spstack/panel_lamp/README.md

# Instrument Panel Lamp

I got this old instrument panel out of a printing press that was (unfortunately) being scrapped.
Decided to make it into a cool looking lamp so it's not only a neat display, but also somewhat functional.

The finished instrument panel lamp
The finished instrument panel lamp

I'm honestly not sure what the panel controlled on the old printing press, but it's pretty cool looking and
has some super satisfying switches to press.

It uses all of the original knobs and buttons to control various aspects of the lamp.

The toggle switch in the center is the main on/off switch for the whole thing. It's wired through one
of the fuses on the front panel as well.

The left knob controls the brightness of the main lamp bulb. It's an autotransformer, so it can just
be directly hooked up to the bulb to control brightness.

The other switches/knobs are tied to an arduino that controls back-lighting LEDs

## Schematic

<a href="images/panel-sch1.jpg">Schematic page 1</a>
<a href="images/panel-sch2.jpg">Schematic page 2</a>
<a href="images/panel-sch3.jpg">Schematic page 3</a>

## PCB Layout

<a href="images/panel-pcb.jpg">PCB layout</a>
