spstack/panel_lamp/(list of files, cad)

Other CAD files:
board_design/components/4914/4914.STEP
board_design/components/IRM_03_5/IRM-03-5.STEP
board_design/components/OSTYK51102030/OSTYK51102030/OSTYK51102030.STEP
board_design/InstrumentPanelLamp/InstrumentPanelLampPcb.step
