spstack/panel_lamp/board_design/InstrumentPanelLamp/InstrumentPanelLamp.kicad_pcb

## KiCad design board_design/InstrumentPanelLamp/InstrumentPanelLamp.kicad_pcb (2026-01-28)

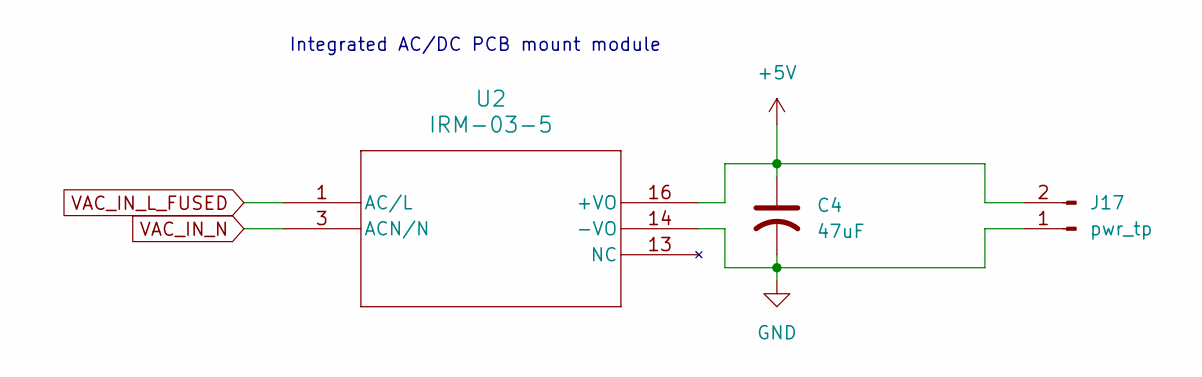
[picture p1: schematic power.kicad_sch]

Parts:
C4: 47uF; CP_Radial_D8.0mm_P3.50mm
J17: pwr_tp; PinHeader_1x02_P2.54mm_Vertical
U2: IRM-03-5; IRM-03_MWU

Connections:
+5V: C4.1, J17.2, U2.16 (+VO); also elsewhere on the board
GND: C4.2, J17.1, U2.14 (-VO); also elsewhere on the board
VAC_IN_L_FUSED: U2.1 (AC/L); also elsewhere on the board
VAC_IN_N: U2.3 (ACN/N); also elsewhere on the board

Notes on the sheet:
Integrated AC/DC PCB mount module

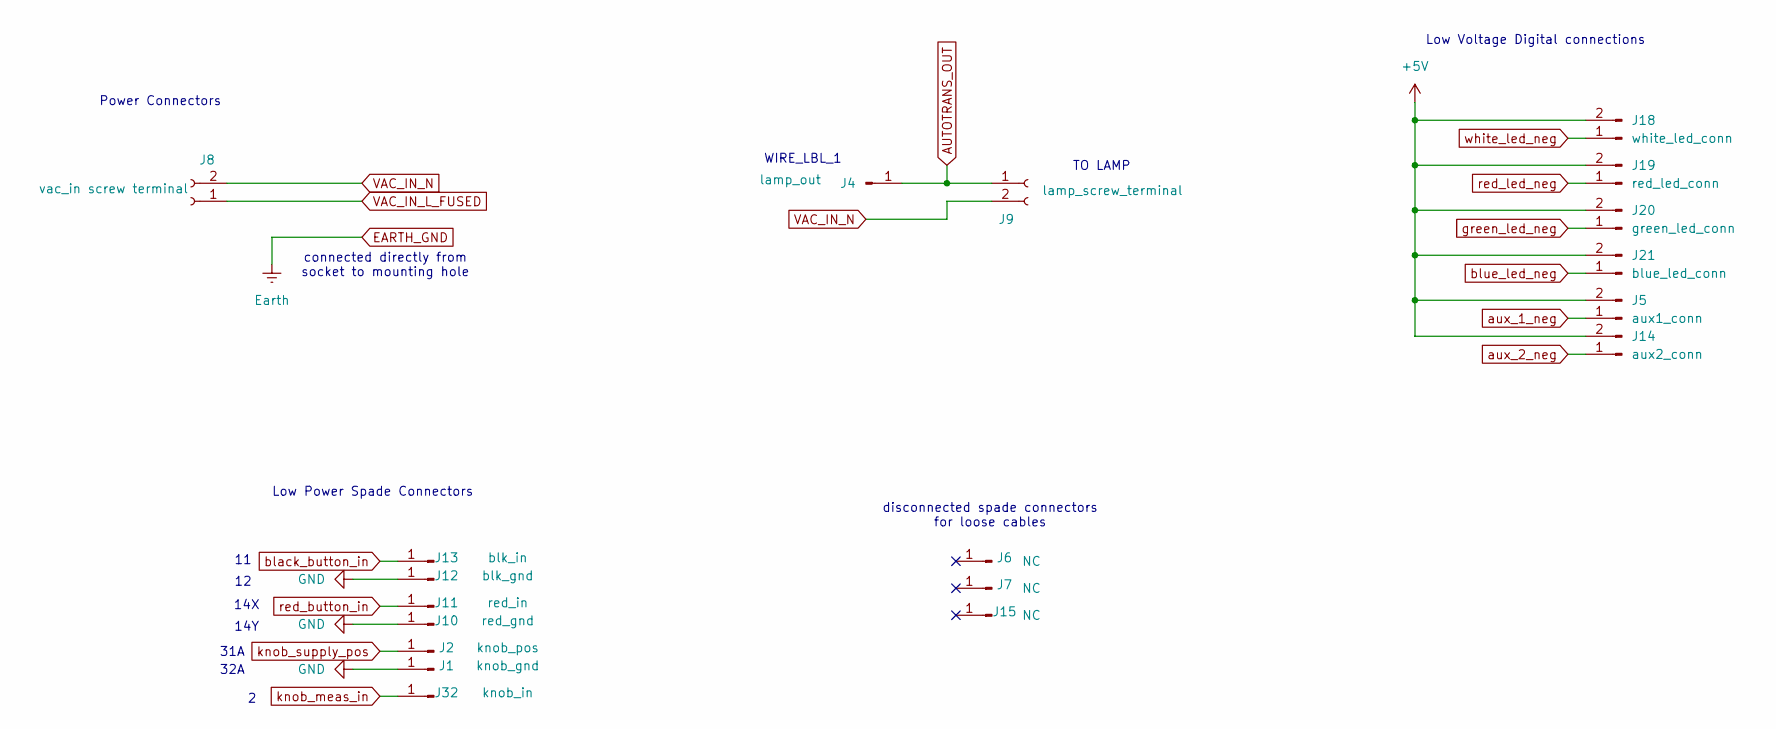
[picture p2: schematic connectors.kicad_sch]

Parts:
J1: knob_gnd; Keystone_4914_90deg_spade_male
J2: knob_pos; Keystone_4914_90deg_spade_male
J4: lamp_out; Keystone_4914_90deg_spade_male
J5: aux1_conn; PinHeader_1x02_P2.54mm_Vertical
J6, J7, J15: NC; Keystone_4914_90deg_spade_male
J8: vac_in screw terminal; CONN2_1102030_OST
J9: lamp_screw_terminal; CONN2_1102030_OST
J10: red_gnd; Keystone_4914_90deg_spade_male
J11: red_in; Keystone_4914_90deg_spade_male
J12: blk_gnd; Keystone_4914_90deg_spade_male
J13: blk_in; Keystone_4914_90deg_spade_male
J14: aux2_conn; PinHeader_1x02_P2.54mm_Vertical
J18: white_led_conn; PinHeader_1x02_P2.54mm_Vertical
J19: red_led_conn; PinHeader_1x02_P2.54mm_Vertical
J20: green_led_conn; PinHeader_1x02_P2.54mm_Vertical
J21: blue_led_conn; PinHeader_1x02_P2.54mm_Vertical
J32: knob_in; Keystone_4914_90deg_spade_male

Connections:
+5V: J5.2, J14.2, J18.2, J19.2, J20.2, J21.2; also elsewhere on the board
AUTOTRANS_OUT: J4.1, J9.1
GND: J1.1, J10.1, J12.1; also elsewhere on the board
VAC_IN_L_FUSED: J8.1; also elsewhere on the board
VAC_IN_N: J8.2, J9.2; also elsewhere on the board
aux_1_neg: J5.1; also elsewhere on the board
aux_2_neg: J14.1; also elsewhere on the board
black_button_in: J13.1; also elsewhere on the board
blue_led_neg: J21.1; also elsewhere on the board
green_led_neg: J20.1; also elsewhere on the board
knob_meas_in: J32.1; also elsewhere on the board
knob_supply_pos: J2.1; also elsewhere on the board
red_button_in: J11.1; also elsewhere on the board
red_led_neg: J19.1; also elsewhere on the board
white_led_neg: J18.1; also elsewhere on the board

Notes on the sheet:
31A
14X
Power Connectors
14Y
Low Voltage Digital connections
32A
WIRE_LBL_1
Low Power Spade Connectors
connected directly from socket to mounting hole
disconnected spade connectors for loose cables
TO LAMP

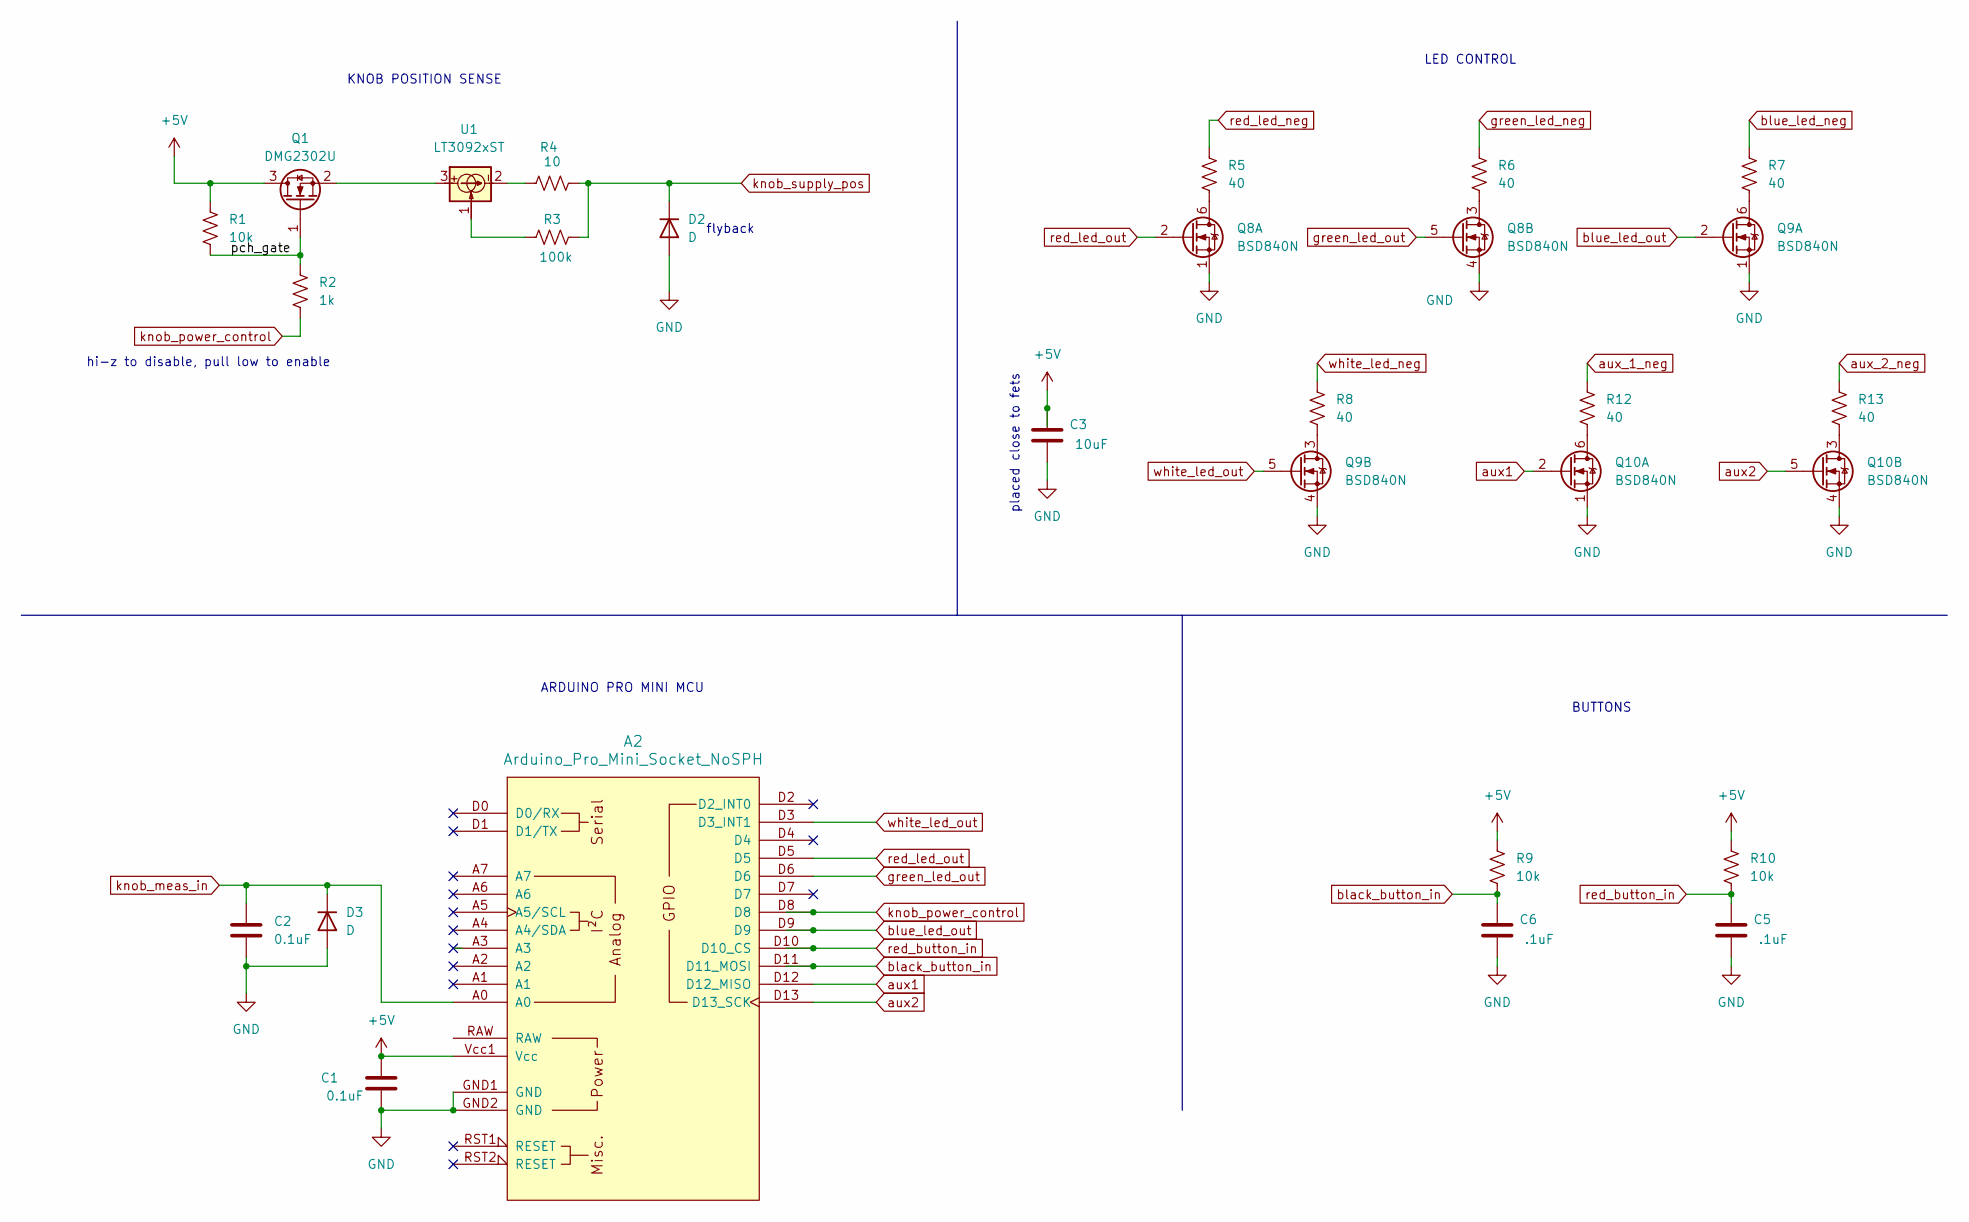
[picture p3: schematic logic.kicad_sch]

Parts:
A2: Arduino_Pro_Mini_Socket_NoSPH
C1, C2: 0.1uF; C_0805_2012Metric_Pad1.18x1.45mm_HandSolder
C3: 10uF; C_0805_2012Metric_Pad1.18x1.45mm_HandSolder
C5, C6: .1uF; C_0805_2012Metric_Pad1.18x1.45mm_HandSolder
D2, D3: D; D_SMA_Handsoldering
Q1: DMG2302U; SOT-23
Q8, Q9, Q10: BSD840N; SOT-363_SC-70-6
R1, R9, R10: 10k; R_0805_2012Metric_Pad1.20x1.40mm_HandSolder
R2: 1k; R_0805_2012Metric_Pad1.20x1.40mm_HandSolder
R3: 100k; R_0805_2012Metric_Pad1.20x1.40mm_HandSolder
R4: 10; R_0805_2012Metric_Pad1.20x1.40mm_HandSolder
R5, R6, R7, R8, R12, R13: 40; R_0805_2012Metric_Pad1.20x1.40mm_HandSolder
U1: LT3092xST; SOT-223-3_TabPin2

Connections:
+5V: A2.Vcc1 (Vcc), C1.1, C3.2, Q1.3 (D), R1.1, R9.1, R10.1; also elsewhere on the board
/logic/pch_gate: Q1.1 (G), R1.2, R2.1
GND: A2.GND1 (GND), A2.GND2 (GND), C1.2, C2.1, C3.1, C5.1, C6.1, D2.2 (A), D3.2 (A), Q8.1 (S), Q8.4 (S), Q9.1 (S), Q9.4 (S), Q10.1 (S), Q10.4 (S); also elsewhere on the board
unnamed: Q1.2 (S), U1.3
unnamed: Q8.6 (D), R5.2
unnamed: Q8.3 (D), R6.2
unnamed: Q9.6 (D), R7.2
unnamed: Q9.3 (D), R8.2
unnamed: Q10.6 (D), R12.2
unnamed: Q10.3 (D), R13.2
unnamed: R3.2, U1.1
unnamed: R4.2, U1.2
aux1: A2.D12 (D12_MISO), Q10.2 (G)
aux2: A2.D13 (D13_SCK), Q10.5 (G)
aux_1_neg: R12.1; also elsewhere on the board
aux_2_neg: R13.1; also elsewhere on the board
black_button_in: A2.D11 (D11_MOSI), C6.2, R9.2; also elsewhere on the board
blue_led_neg: R7.1; also elsewhere on the board
blue_led_out: A2.D9, Q9.2 (G)
green_led_neg: R6.1; also elsewhere on the board
green_led_out: A2.D6, Q8.5 (G)
knob_meas_in: A2.A0, C2.2, D3.1 (K); also elsewhere on the board
knob_power_control: A2.D8, R2.2
knob_supply_pos: D2.1 (K), R3.1, R4.1; also elsewhere on the board
red_button_in: A2.D10 (D10_CS), C5.2, R10.2; also elsewhere on the board
red_led_neg: R5.1; also elsewhere on the board
red_led_out: A2.D5, Q8.2 (G)
white_led_neg: R8.1; also elsewhere on the board
white_led_out: A2.D3 (D3_INT1), Q9.5 (G)

Notes on the sheet:
flyback
KNOB POSITION SENSE
placed close to fets
BUTTONS
ARDUINO PRO MINI MCU
LED CONTROL
hi-z to disable, pull low to enable

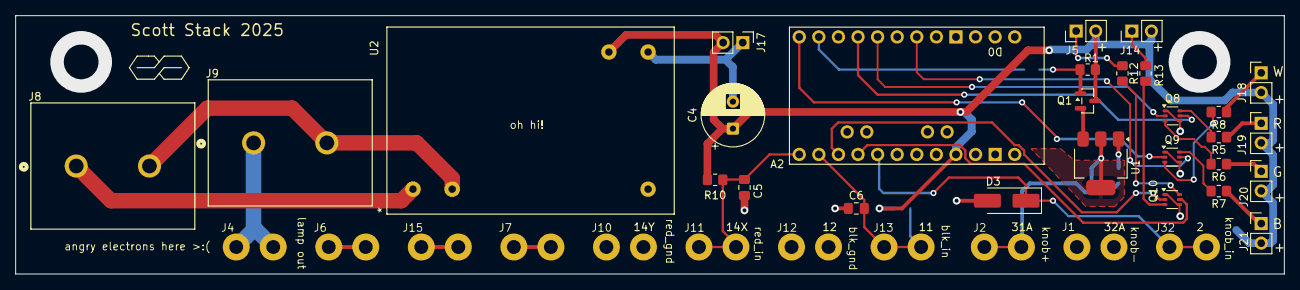
[picture p4: board InstrumentPanelLamp.kicad_pcb from above]

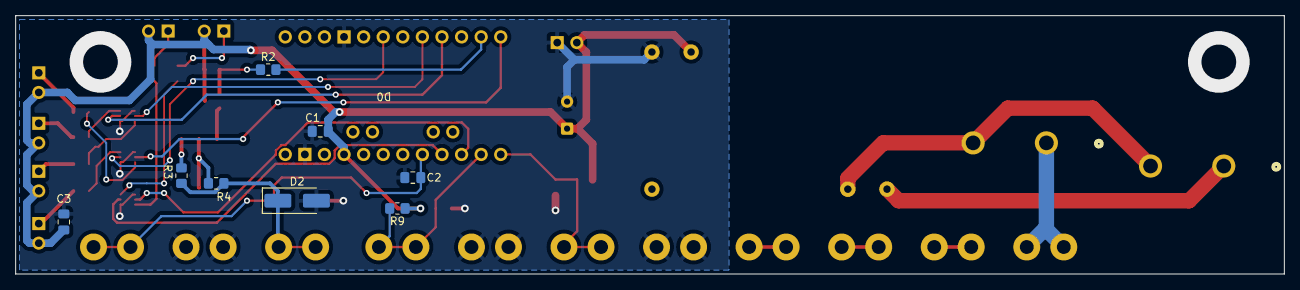
[picture p5: board InstrumentPanelLamp.kicad_pcb from below]

Board: 2 copper layers, 164.5 x 33.5 mm, 47 parts (8 on the bottom side), 32 nets.
