spstack/panel_lamp/(commit log)

2025-11-15 Move pcb files to new board_design directory, add arduino sketch, and update pico LampPicoProject
    Lots of updates here because I forgot to commit for a while.
    - Updating Pico version of the code to actually be functional (now has LED updates and knob reading)
    - Adding Arduino sketch for controlling the lamp via Arduino because I might need to switch
    to a Pro mini for space reasons on the pcb
    - Move PCB design to new board_design directory structure
    - Finish the schematic for thew PCB design that uses the PI Pico
    - Start on layout of the PCB, but probably have to redo it with a smaller MCU
2025-11-18 Complete initial version of Arduino code and initial PCB placement
    The arduino sketch is now as functional as the old version was.
    The kicab pcb file has the initial placement of components done as
    well using the updated Arduino pro mini as the MCU.
2026-01-28 ardiuino sketch: implement smooth RGB color cycling for the panel lamp and fix brightness
    - Adding RGB color cycling with smooth transitions between colors
    - Add states for Red, Green, and Blue static colors
    - Fix brightness calculation to use full 0-255 range for PWM control
2026-01-28 board: Update board/sch design files with 3d model changes
2026-05-09 Cleanup git repository in preparation for adding to github
    - remove the Pico project that is no longer used
    - add larger files to git lfs
    - update .gitignore to ignore more files that are not needed in the repository
    - add gerber files and step files for the PCB release to the repository
    - generate a PDF of the schematic and add it to the repository
